azlan-works/Argo/README.md

# Argo v2

## Crowdsupply:

Argo is soon to launch on CrowdSupply, sign up now to be updated as soon as it's live and ready for pre-order!

https://www.crowdsupply.com/azlan-works/argo-cm5

A080620E-1A4C-4EFC-86CE-AD3B6DF5B84E_1_105_c

## Mainboard
The main board houses the CM5 and breaks out the most basic functionality needed.

- 2x 100pin Hirose Connectors
- 2x MIPI-DSI/CSI
- 1x Micro-HDMI
- 1x HDMI FPC connector for external break out
- 1x PCIe FPC connector, Pi 5 compatible
- 2x USB-C (One for power/flashing - USB 2.0 and one regular USB 3.0)
- Integrated BMS (BQ25895) with up to 5A charging dependent on battery used.
- TPS61022 5V boost for upto 3A of constant power from battery or USB.
- I2C control for BQ25895 with ADC battery level monitoring.
- Onboard LSM6DSV16XTR IMU via I2C

Read more about the mainboard [here](./mainboard.md)
## Benchmarks:

Benchmarks conducted using v1 boards using CM5 16GB RAM and 64GB eMMC + Waveshare CM5 cooler with fan.

### On Adapter:


### On Battery:


## Expansion Boards:

### M.2 PCIe Expansion:
- Adds an M.2 M-Key Slot for external SSD
Read more about the SSD board [here](./ssdboard.md)

### Impedance Calculations:



### OSHWA Certification:

PNG image

## Sponsored by OSHWLab Stars:
 &nbsp;

 </br>
 </br>
 
   &nbsp; &nbsp; &nbsp; &nbsp; &nbsp;  
 &nbsp;
  &nbsp;
   &nbsp;

</br></br>

Huge thanks to Bob from OSHWLab for all the support and sponsoring the PCBA! 

## Note:

Commerical reproduction is NOT permitted for this design without prior agreements.
