azlan-works/Argo/KiCad/readme.md

This KiCad project is just an export of the OSHWLab project, details may not match 100%
