azlan-works/Argo/ssdboard.md

SSD Board in Argo footprint.
Support M.2 2230 and 2242 sizes NVMe SSDs. Based on offical CM5 M.2 HAT+ 4-layer SIG/PWR : GND : GND : SIG/PWR stackup.

# Layer 1:



# Layer 2 - GND:



# Layer 3 - GND:



# Layer 4:
