azlan-works/Argo/mainboard.md

# Mainboard Specifications:

The mainboard is a 6 Layer 1.6mm PCB and uses the JLCPCB JLC06161H-3313 stackup. The layer distribution used is: [SIG/PWR : GND : SIG/PWR : PWR(5V) : GND : SIG/PWR]

# Layer 1:



# Layer 2 - GND:



# Layer 3:



# Layer 4 - 5V:



# Layer 5 - GND:



# Layer 6:
