azlan-works/Argo/Argo_v2_Schematic.pdf

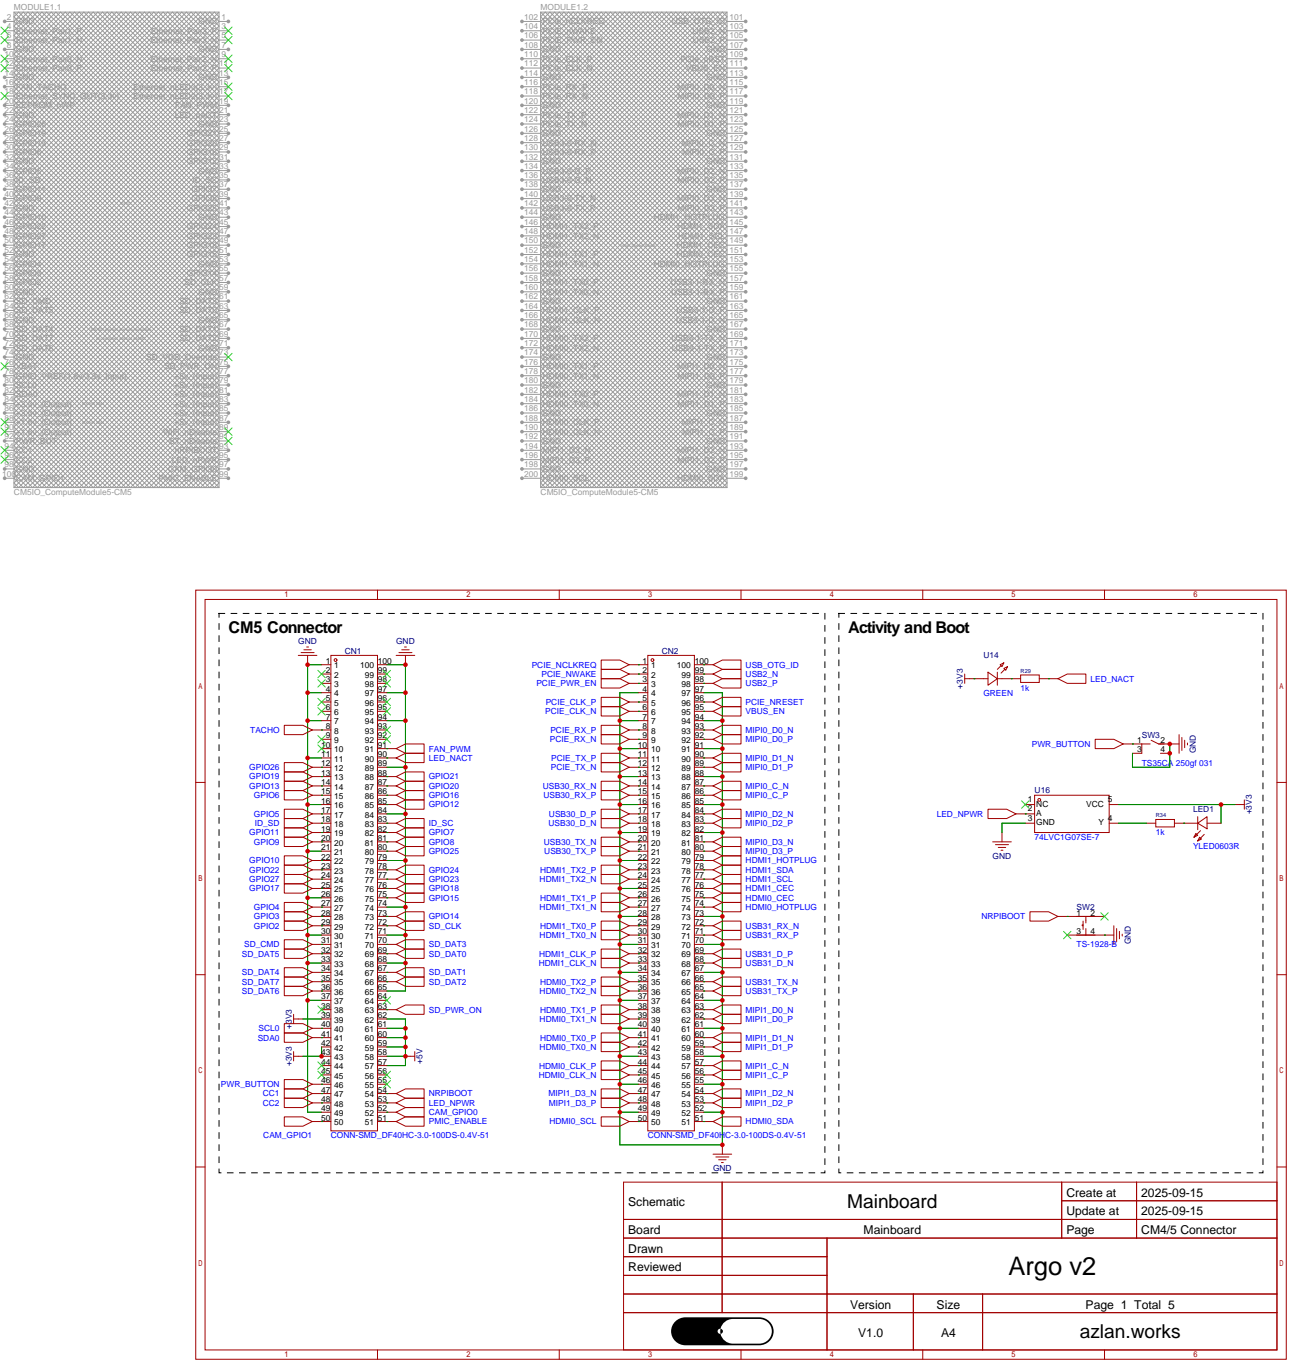
[picture p1: page 1]

NB SD signals are only available
on modules without eMMC

Schematic | Mainboard | Create at | 2025-09-15

Update at | 2025-09-15

Board | Mainboard | Page | CM4/5 Connector
Drawn | | Argo v2
Reviewed

Version | Size | Page 1 Total 5
V1.0 | A4 | azlan.works

# BQ25895 Charger

# USB-C Input

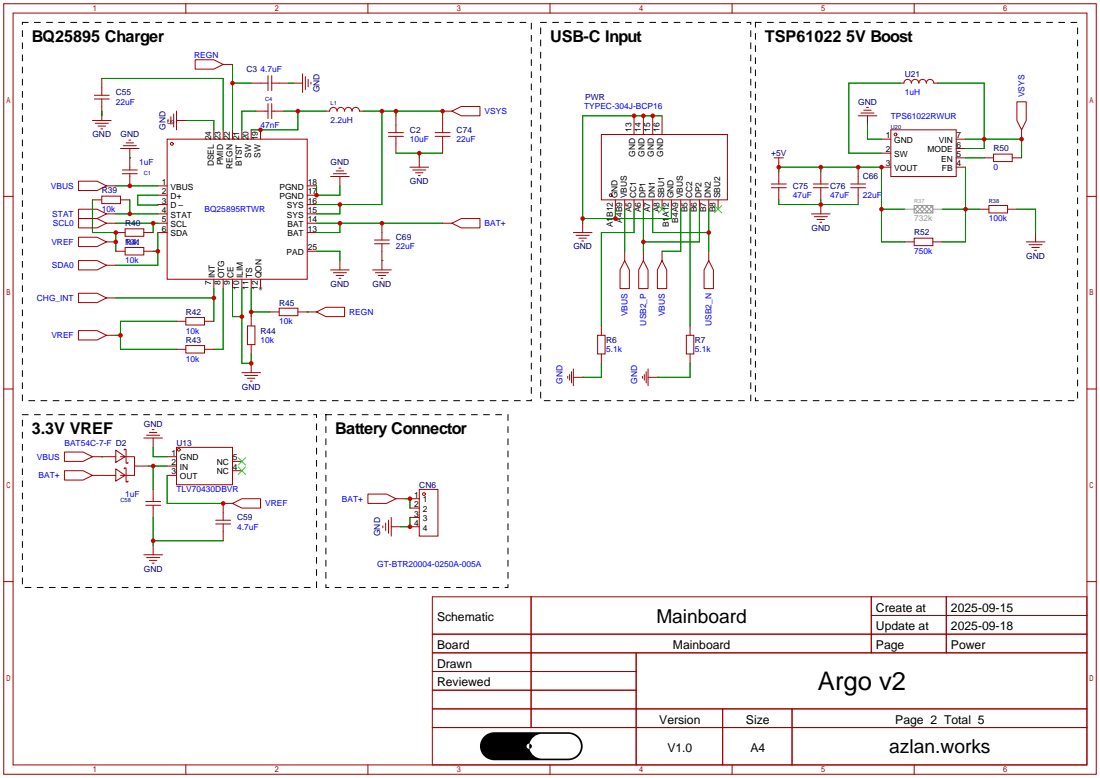
[picture p2: page 2]

BAT 13 BAT 14 SYS 15 SYS 16 PGND 17 PGND 18

Schematic | Mainboard | Create at | 2025-09-15

Update at | 2025-09-18

Board | Mainboard | Page | Power
Drawn | | Argo v2
Reviewed

# DPHY1

# PCIe +5V

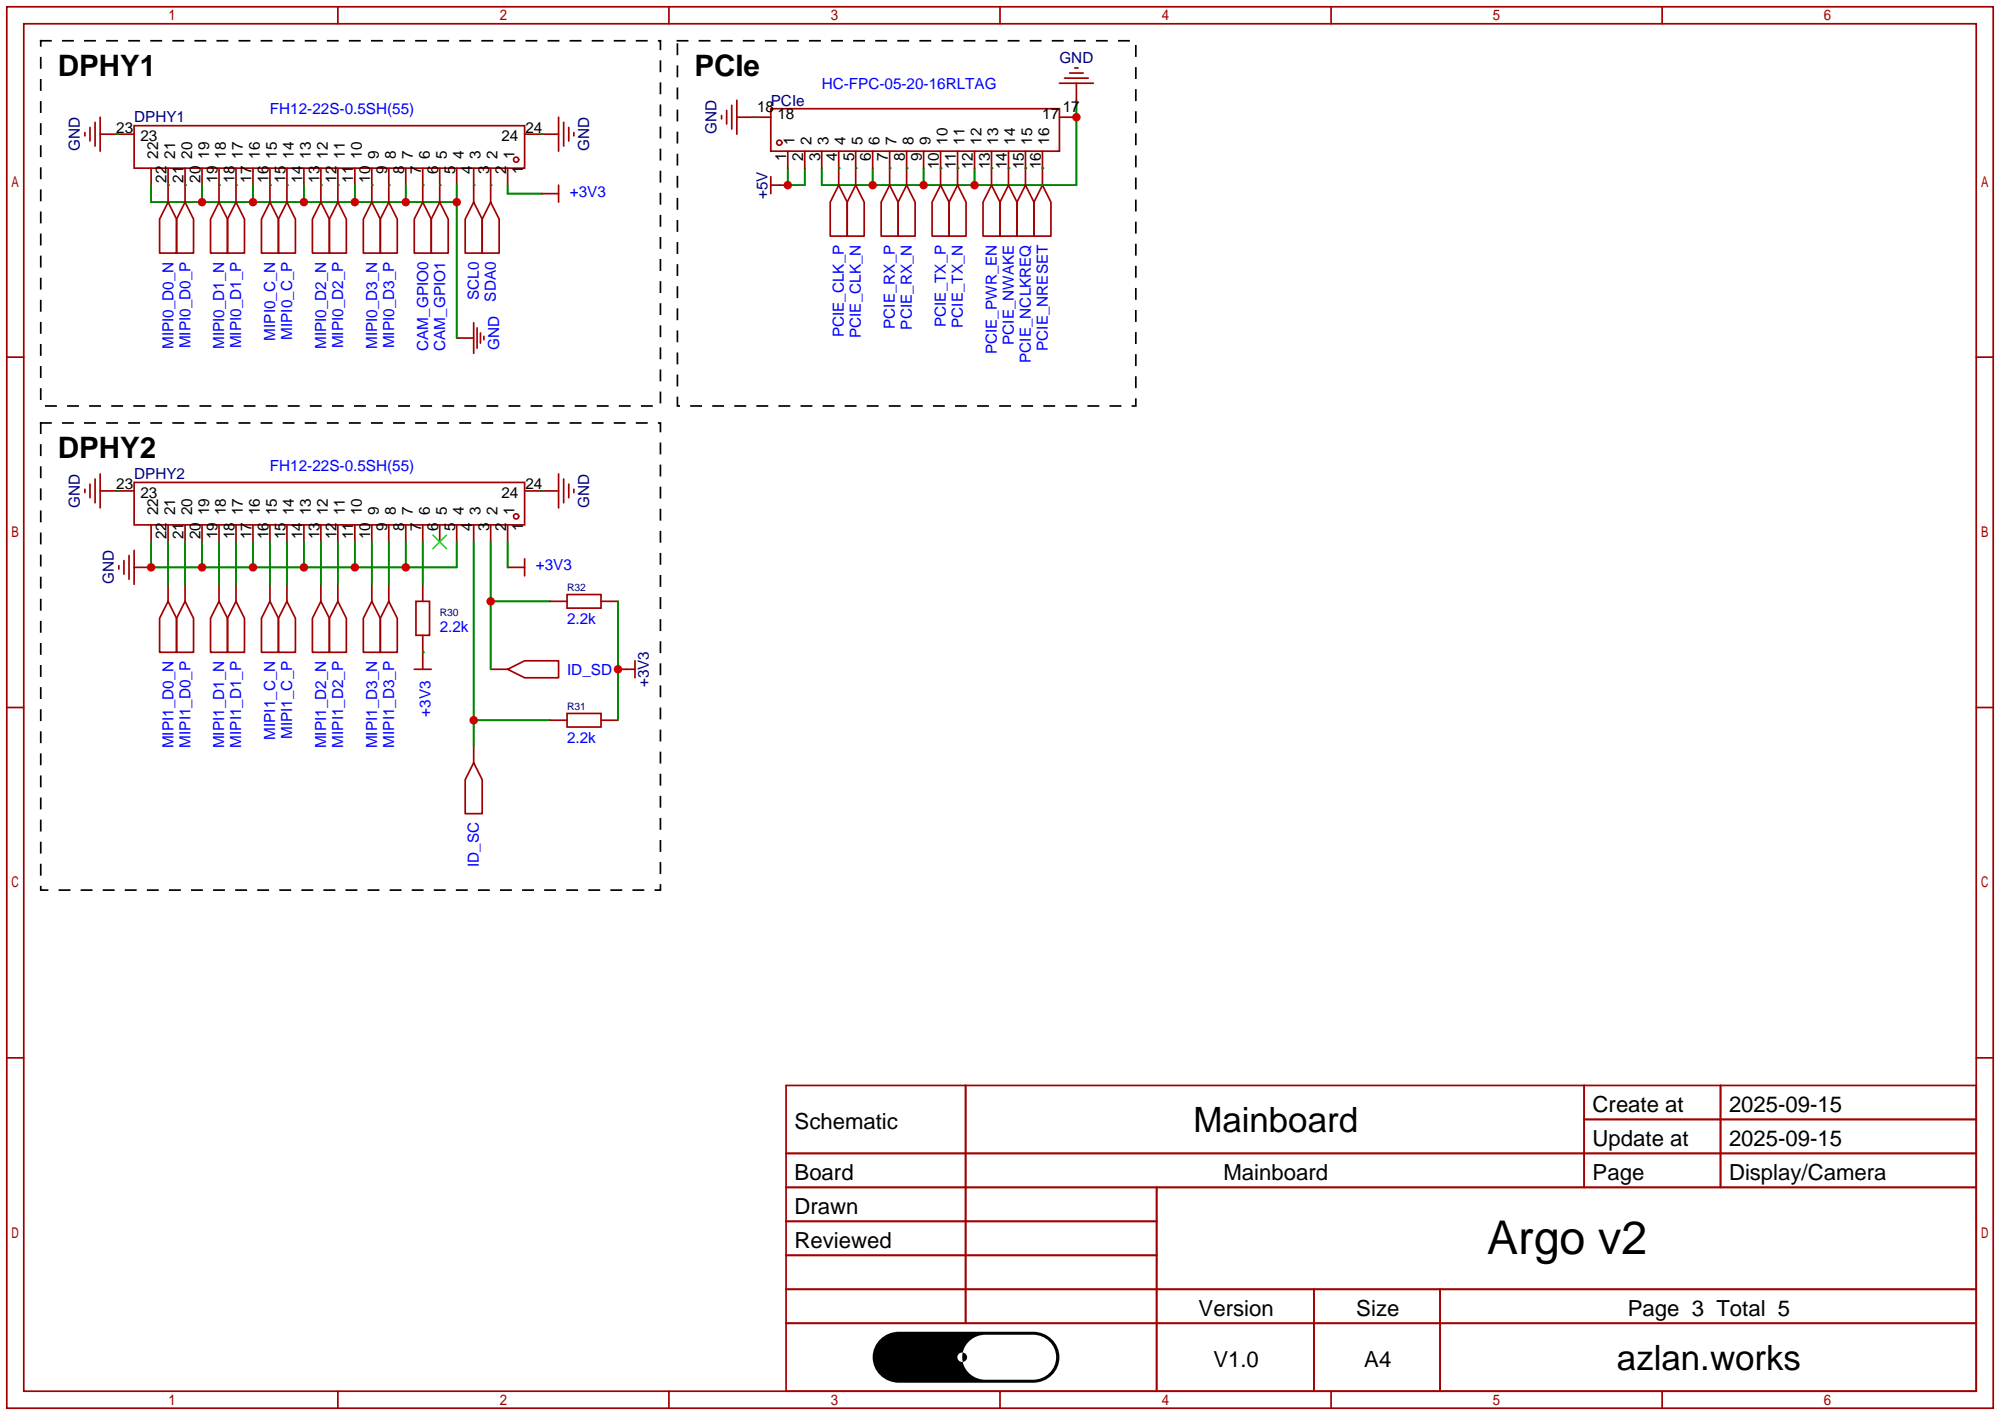
[picture p3: page 3]

Schematic | Mainboard | Create at | 2025-09-15

Update at | 2025-09-15

Board | Mainboard | Page | Display/Camera
Drawn | | Argo v2
Reviewed

# GND TACHO

# HDMI

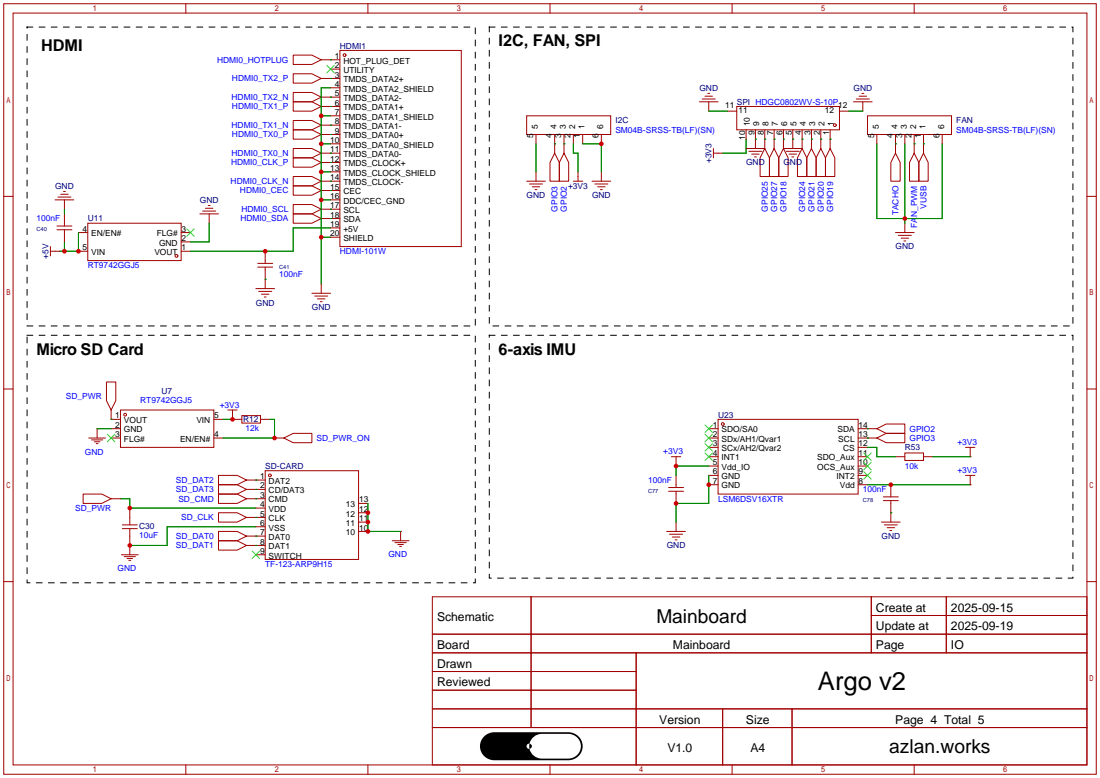
[picture p4: page 4]

FAN
SM04B-SRSS-TB(LF)(SN)

Schematic | Mainboard | Create at | 2025-09-15

Update at | 2025-09-19

Board | Mainboard | Page | IO
Drawn | | Argo v2
Reviewed

# USB Power (500mA max)

# USB 3.0 SS Mux

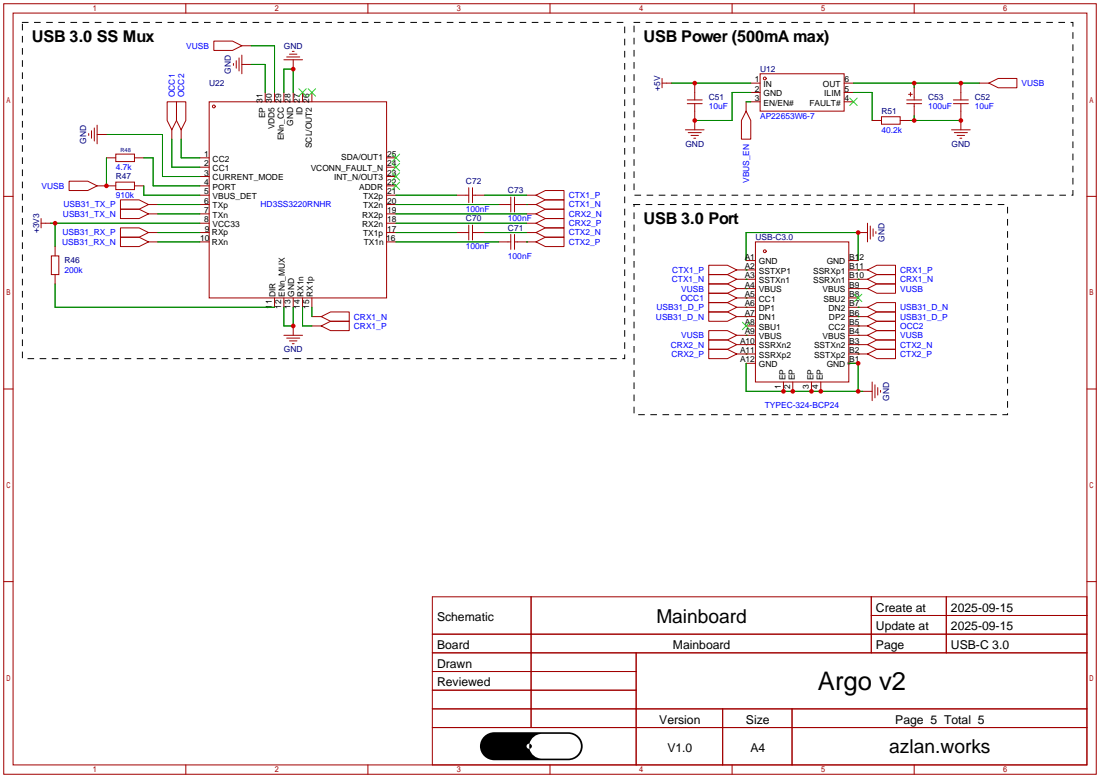
[picture p5: page 5]

Schematic | Mainboard | Create at | 2025-09-15

Update at | 2025-09-15

Board | Mainboard | Page | USB-C 3.0
Drawn | | Argo v2
Reviewed
