azlan-works/Argo/(list of files, drawings)

Other design files:
Argo_v2_Project.epro
