azlan-works/Argo/KiCad/argo-v2.kicad_pcb

## KiCad design KiCad/argo-v2.kicad_pcb (2026-09-20)

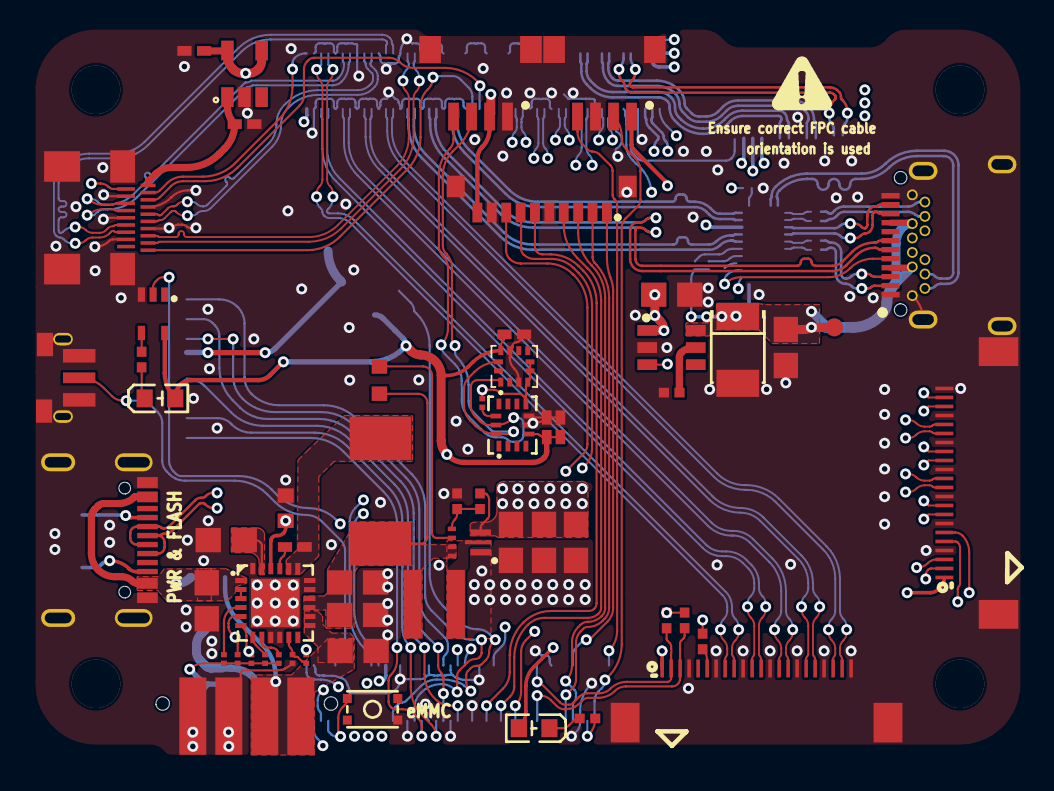
[picture p6: board argo-v2.kicad_pcb from above]

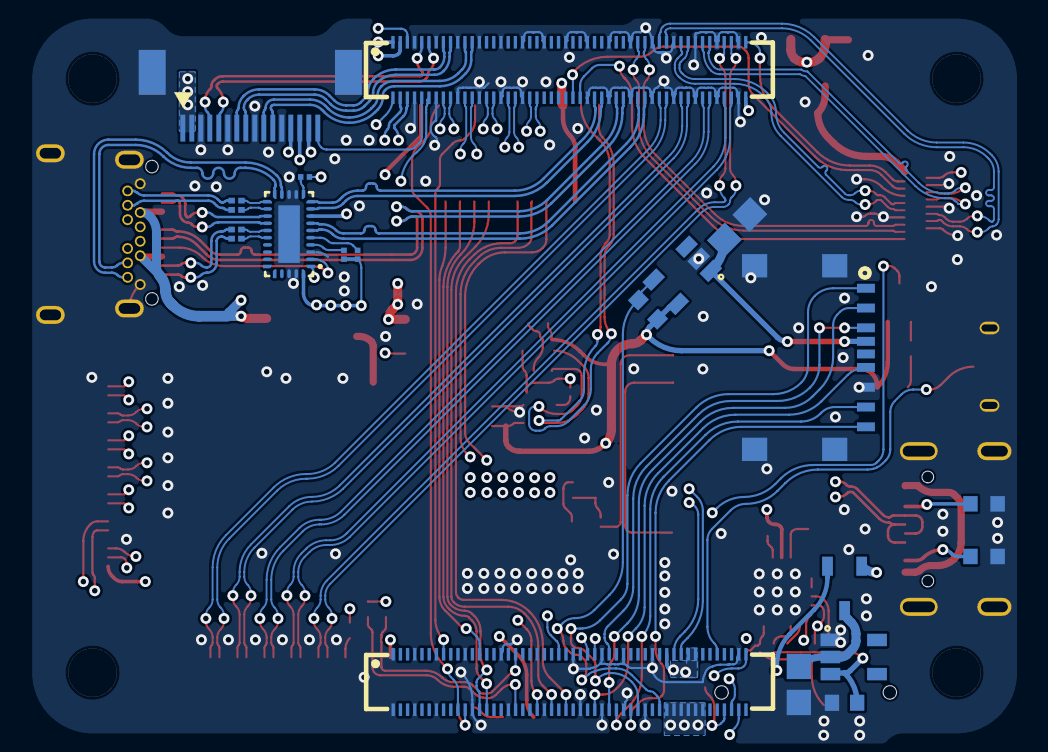
[picture p7: board argo-v2.kicad_pcb from below]

Board: 6 copper layers, 79 parts (22 on the bottom side), 127 nets.

Parts:
C1, C2, C30, C51, C52, C55, C58, C66, C69, C74, C75, C76: C0805
C3, C59: C0603
C4, C40, C41, C77, C78, C81: C0402
C53: CASE-B_3528
C70, C71, C72, C73: C0201
CN1, CN2: CONN-SMD_DF40HC-3.0-100DS-0.4V-51
CN6: CONN-SMD_GT-BTR20004-0250A-005A
D2: SOT-23-3_L2.9-W1.6-P1.90-LS2.8-BR
DPHY1, DPHY2: FPC-SMD_22P-P0.50_FH12-22S-0.5SH-55
FAN: CONN-SMD_4P-P1.00_SM04B-SRSS-TB-LF-SN
HDMI1: HDMI-SMD_HDMI-101W
I2C: CONN-SMD_4P-P1.00_SM04B-SRSS-TB-LF-SN
L1: IND-SMD_L6.5-W6.5_IHLP-2525
LED1: LED0603-FD
MODULE1: CM5IO{colon}Raspberry-Pi-5-Compute-Module
PCIe: FPC-SMD_16P-P0.50_HC-FPC-05-20-16RLTAG
PWR: USB-C-SMD_TYPEC-304J-BCP16
R6, R7, R12, R50: R0603
R29, R30, R31, R32, R34, R38, R51, R52: R0402
R39, R40, R41, R42, R43, R44, R45, R46, R47, R48, R53: R0201
SD-CARD: TF-SMD_TF-123-ARP9H15
SPI: CONN-SMD_10P-P0.80_HDGC0802WV-S-10P
SW2: KEY-SMD_4P-L2.8-W2.0-P1.20-LS3.0-TL
SW3: KEY-SMD_TS35CA-100GF-031
U7, U11, U13: TSOT-23-5_L2.9-W1.6-P0.95-LS2.8-BR
U9: QFN-24_L4.0-W4.0-P0.50-TL-EP2.7
U12: SOT-23-6_L2.9-W1.6-P0.95-LS2.8-BR
U14: LED0603-FD
U16: SC-88A_L2.0-W1.3-P0.65-LS2.1-BL
U20: VQFN-7_L2.0-W2.0-P0.55-TL_RWU
U21: IND-SMD_L4.1-W4.1_PA5430
U22: WQFN-30_L4.5-W2.5-P0.4-BL-EP
U23: LGA-14_L3.0-W2.5-P0.50-BR
U24: LGA-12_L2.0-W2.0-P0.50-BL
USB-C3.0: USB-C-SMD_TYPEC-324-BCP24

Connections:
$1N10774: R29.2, U14.2
$1N12706: R34.1, U16.4
$1N12751: LED1.2, R34.2
$2N4744: C4.1, U9.21
$2N5637: R44.2, R45.1, U9.11
$2N10575: U9.2, U9.3
$2N18023: C55.2, U9.23
$2N19126: PWR.A5, R6.1
$2N19130: PWR.B5, R7.1
$2N22099: R43.2, U9.8
$2N22411: C58.1, D2.3, U13.2
$2N49032: C4.2, L1.1, U9.19, U9.20
$2N49283: U20.2, U21.1
$2N51141: R50.1, U20.5
$2N51424: R38.2, R52.2, U20.4
$3N4264: DPHY2.6, R30.2
$4N5235: C41.2, HDMI1.19, U11.1
$4N37129: R53.1, U23.12
$5N11984: R51.1, U12.5
$5N17176: R46.1, U22.11
$5N17396: C73.1, U22.20
$5N17400: C72.1, U22.21
$5N17408: C70.1, U22.17
$5N17508: R47.2, U22.5
$5N17549: R48.2, U22.4
$5N17793: C71.1, U22.16
+3V3: C77.2, C78.2, C81.2, CN1.39, CN1.42, CN1.43, DPHY1.1, DPHY2.1, I2C.2, LED1.1, R12.1, R30.1, R31.1, R32.1, R46.2, R53.2, SPI.10, U7.5, U14.1, U16.5, U22.8, U23.5, U23.8, U24.4, U24.5, U24.6, U24.10
+5V: C40.1, C51.1, C66.2, C75.2, C76.2, CN1.57, CN1.58, CN1.59, CN1.60, CN1.61, CN1.62, PCIe.1, PCIe.2, R52.1, U11.4, U11.5, U12.1, U20.3
BAT+: C69.1, CN6.1, CN6.2, D2.2, U9.13, U9.14
CAM_GPIO0: CN1.52, DPHY1.6
CAM_GPIO1: CN1.50, DPHY1.5
CHG_INT: R42.2, U9.7
CRX1_N: U22.15, USB-C3.0.B10
CRX1_P: U22.14, USB-C3.0.B11
CRX2_N: U22.19, USB-C3.0.A10
CRX2_P: U22.18, USB-C3.0.A11
CTX1_N: C73.2, USB-C3.0.A3
CTX1_P: C72.2, USB-C3.0.A2
CTX2_N: C70.2, USB-C3.0.B3
CTX2_P: C71.2, USB-C3.0.B2
FAN_PWM: CN1.91, FAN.2
GND: C1.1, C2.1, C3.1, C30.1, C40.2, C41.1, C51.2, C52.1, C53.2, C55.1, C58.2, C59.2, C66.1, C69.2, C74.2, C75.1, C76.1, C77.1, C78.1, C81.1, CN1.1, CN1.4, CN1.7, CN1.11, CN1.16, CN1.21, CN1.26, CN1.30, CN1.33, CN1.37, CN1.49, CN1.65, CN1.68, CN1.71, CN1.74, CN1.79, CN1.84, CN1.89, CN1.94, CN1.97, CN1.100, CN2.4, CN2.7, CN2.10, CN2.13, CN2.16, CN2.19, CN2.22, CN2.25, CN2.28, CN2.31, CN2.34, CN2.37, CN2.40, CN2.43, CN2.46, CN2.49, CN2.52, CN2.55, CN2.58, CN2.61, CN2.64, CN2.67, CN2.70, CN2.73, CN2.82, CN2.85, CN2.88, CN2.91, CN2.94, CN2.97, CN6.3, CN6.4, DPHY1.4, DPHY1.7, DPHY1.10, DPHY1.13, DPHY1.16, DPHY1.19, DPHY1.22, DPHY1.23, DPHY1.24, DPHY2.4, DPHY2.7, DPHY2.10, DPHY2.13, DPHY2.16, DPHY2.19, DPHY2.22, DPHY2.23, DPHY2.24, FAN.3, FAN.5, FAN.6, HDMI1.4, HDMI1.7, HDMI1.10, HDMI1.13, HDMI1.16, HDMI1.20, I2C.1, I2C.5, I2C.6, PCIe.3, PCIe.6, PCIe.9, PCIe.12, PCIe.17, PCIe.18, PWR.13, PWR.14, PWR.15, PWR.16, PWR.A1B12, PWR.B1A12, R6.2, R7.2, R38.1, R44.1, R51.2, SD-CARD.6, SD-CARD.10, SD-CARD.11, SD-CARD.12, SD-CARD.13, SPI.5, SPI.9, SPI.11, SPI.12, SW2.4, SW3.1, SW3.3, SW3.4, U7.2, U9.9, U9.10, U9.17, U9.18, U9.24, U9.25, U11.2, U12.2, U13.1, U16.3, U20.1, U22.3, U22.12, U22.13, U22.28, U22.29, U22.31, U23.6, U23.7, U24.3, U24.9, USB-C3.0.1, USB-C3.0.2, USB-C3.0.3, USB-C3.0.4, USB-C3.0.A1, USB-C3.0.A12, USB-C3.0.B1, USB-C3.0.B12
GPIO2: CN1.29, I2C.3, R41.2, U9.6, U23.14, U24.11
GPIO3: CN1.28, I2C.4, R40.2, U9.5, U23.13, U24.1
GPIO18: CN1.76, SPI.6
GPIO19: CN1.13, SPI.1
GPIO20: CN1.87, SPI.2
GPIO21: CN1.88, SPI.3
GPIO24: CN1.78, SPI.4
GPIO25: CN1.80, SPI.8
GPIO27: CN1.24, SPI.7
HDMI0_CEC: CN2.75, HDMI1.15
HDMI0_CLK_N: CN2.45, HDMI1.14
HDMI0_CLK_P: CN2.44, HDMI1.12
HDMI0_HOTPLUG: CN2.74, HDMI1.1
HDMI0_SCL: CN2.50, HDMI1.17
HDMI0_SDA: CN2.51, HDMI1.18
HDMI0_TX0_N: CN2.42, HDMI1.11
HDMI0_TX0_P: CN2.41, HDMI1.9
HDMI0_TX1_N: CN2.39, HDMI1.8
HDMI0_TX1_P: CN2.38, HDMI1.6
HDMI0_TX2_N: CN2.36, HDMI1.5
HDMI0_TX2_P: CN2.35, HDMI1.3
ID_SC: CN1.83, DPHY2.3, R31.2
ID_SD: CN1.18, DPHY2.2, R32.2
LED_NACT: CN1.90, R29.1
LED_NPWR: CN1.53, U16.2
MIPI0_C_N: CN2.87, DPHY1.15
MIPI0_C_P: CN2.86, DPHY1.14
MIPI0_D0_N: CN2.93, DPHY1.21
MIPI0_D0_P: CN2.92, DPHY1.20
MIPI0_D1_N: CN2.90, DPHY1.18
MIPI0_D1_P: CN2.89, DPHY1.17
MIPI0_D2_N: CN2.84, DPHY1.12
MIPI0_D2_P: CN2.83, DPHY1.11
MIPI0_D3_N: CN2.81, DPHY1.9
MIPI0_D3_P: CN2.80, DPHY1.8
MIPI1_C_N: CN2.57, DPHY2.15
MIPI1_C_P: CN2.56, DPHY2.14
MIPI1_D0_N: CN2.63, DPHY2.21
MIPI1_D0_P: CN2.62, DPHY2.20
MIPI1_D1_N: CN2.60, DPHY2.18
MIPI1_D1_P: CN2.59, DPHY2.17
MIPI1_D2_N: CN2.54, DPHY2.12
MIPI1_D2_P: CN2.53, DPHY2.11
MIPI1_D3_N: CN2.47, DPHY2.9
MIPI1_D3_P: CN2.48, DPHY2.8
NRPIBOOT: CN1.54, SW2.1
OCC1: U22.2, USB-C3.0.A5
OCC2: U22.1, USB-C3.0.B5
PCIE_CLK_N: CN2.6, PCIe.5
PCIE_CLK_P: CN2.5, PCIe.4
PCIE_NCLKREQ: CN2.1, PCIe.15
PCIE_NRESET: CN2.96, PCIe.16
PCIE_NWAKE: CN2.2, PCIe.14
PCIE_PWR_EN: CN2.3, PCIe.13
PCIE_RX_N: CN2.9, PCIe.8
PCIE_RX_P: CN2.8, PCIe.7
PCIE_TX_N: CN2.12, PCIe.11
PCIE_TX_P: CN2.11, PCIe.10
PWR_BUTTON: CN1.46, SW3.2
REGN: C3.2, R45.2, U9.22
SCL0: CN1.40, DPHY1.3
SDA0: CN1.41, DPHY1.2
SD_CLK: CN1.72, SD-CARD.5
SD_CMD: CN1.31, SD-CARD.3
SD_DAT0: CN1.69, SD-CARD.7
SD_DAT1: CN1.67, SD-CARD.8
SD_DAT2: CN1.66, SD-CARD.1
SD_DAT3: CN1.70, SD-CARD.2
SD_PWR: C30.2, SD-CARD.4, U7.1
SD_PWR_ON: CN1.63, R12.2, U7.4
STAT: R39.2, U9.4
TACHO: CN1.8, FAN.4
USB2_N: CN2.99, PWR.A7, PWR.B7
USB2_P: CN2.98, PWR.A6, PWR.B6
USB31_D_N: CN2.68, USB-C3.0.A7, USB-C3.0.B7
USB31_D_P: CN2.69, USB-C3.0.A6, USB-C3.0.B6
USB31_RX_N: CN2.72, U22.10
USB31_RX_P: CN2.71, U22.9
USB31_TX_N: CN2.66, U22.7
USB31_TX_P: CN2.65, U22.6
VBUS: C1.2, D2.1, PWR.A4B9, PWR.B4A9, U9.1
VBUS_EN: CN2.95, U12.3
VREF: C59.1, R39.1, R40.1, R41.1, R42.1, R43.1, U13.3
VSYS: C2.2, C74.1, L1.2, R50.2, U9.15, U9.16, U20.6, U20.7, U21.2
VUSB: C52.2, C53.1, FAN.1, R47.1, R48.1, U12.6, U22.30, USB-C3.0.A4, USB-C3.0.A9, USB-C3.0.B4, USB-C3.0.B9
