azlan-works/Argo/(threads)

Thread 1 (2025-08-27):

Schematics is missing the mipi csi?

Grabber, 2025-08-27:

Babyyoda777, 2025-08-27:
DHPY1 and DPHY2 are dual purpose MIPI DSI/CSI ports as documented in the CM5 datasheet :)

Thread 2 (2025-09-02):

Question on having a blade version of this.

enyachoke, 2025-09-02:
Hello. I just bumped into this, a little introduction, I am a software engineer and a homelab enthusiast. I have a bunch of ARM boards in my lab, but my biggest pain has always been powering them in a clean way (i.e having a power brick for each of them is a real pain).  How hard would it be to have a 1U version of this with an SSD and Ethernet, with at least a 5-node backplane providing power, and probably a way for blade number 1 to be able to manage the other blades (Main uploading flash images. I'm looking at a case where I have a piece of software that can download and flash images)?

Babyyoda777, 2025-09-02:
Hi! Thanks for your interest! I feel Argo doesn't really suit the needs you're looking for. This board aims to be pretty much standalone and very very small to the point where adding the back plane connector for interfacing in a cluster system would make be a bit uncomfortable 😅

I believe something like the Compute Blade or Sipeed's Compute module cluster system would be a much more viable option. Sorry about that but if I get time I can try look into it as another project!

As for both Ethernet and an SSD, that would be possible via a PCIe switch board and then having a PCIe Ethernet switch on one and SSD on the other. Unfortunately as before, since the CM5 has one lane of PCIE x3.0 your bandwidth will be limited compared to a proper setup using onboard Ethernet etc.

Closed 2025-09-02.
